pdx-robotics/ElectricSpeedController/Images/20180814_091748.jpg

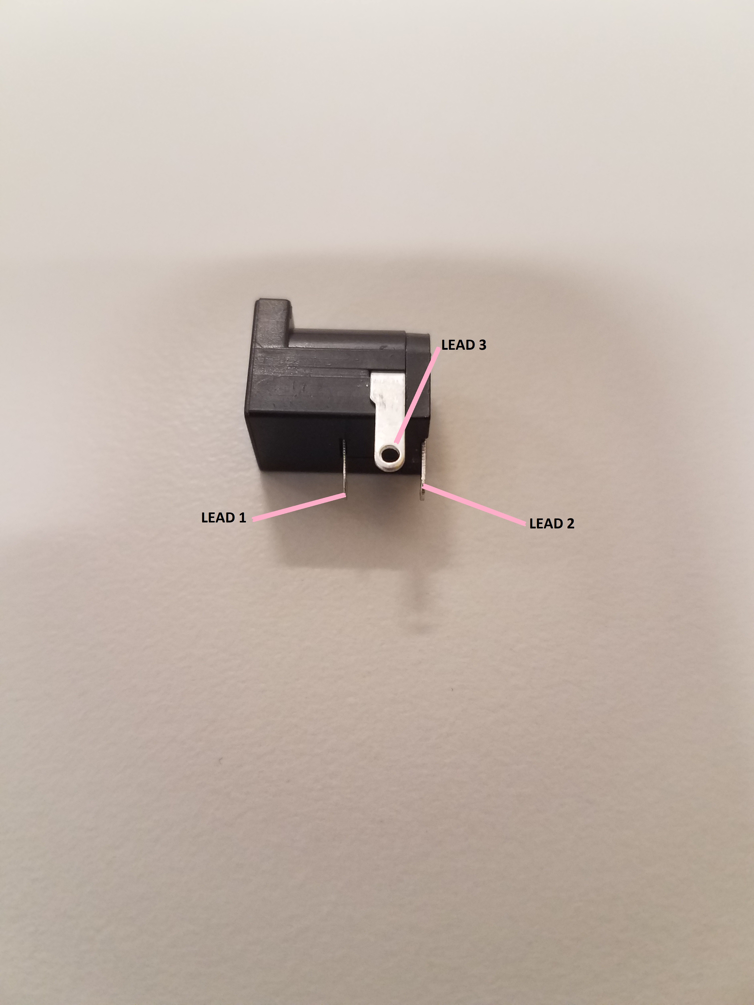
Images/20180814_091748.jpg
