pdx-robotics/ElectricSpeedController/Images/20180814_091755.jpg

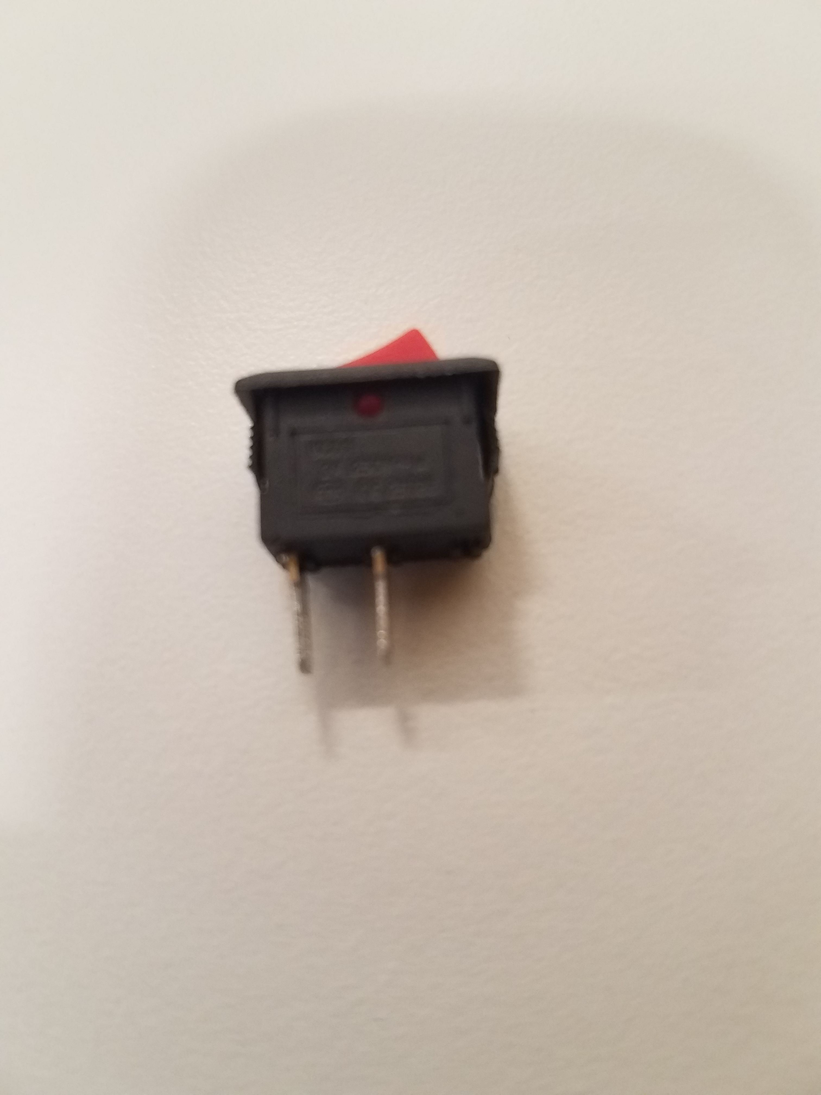
Images/20180814_091755.jpg
