pdx-robotics/ElectricSpeedController/Images/61D4g5iEZIL._SL1100_.jpg

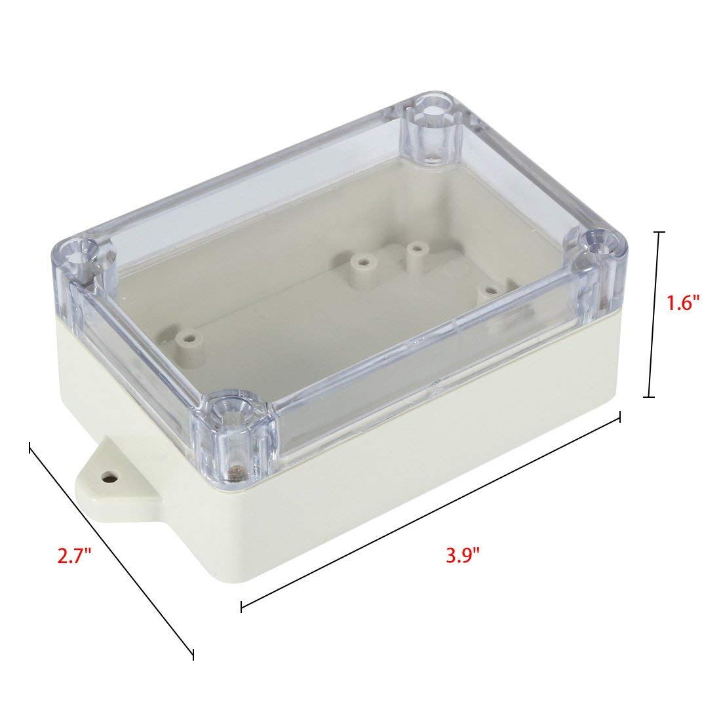
Images/61D4g5iEZIL._SL1100_.jpg
