pdx-robotics/ElectricSpeedController/Images/61FMiCF3CWL._SL1200_.jpg

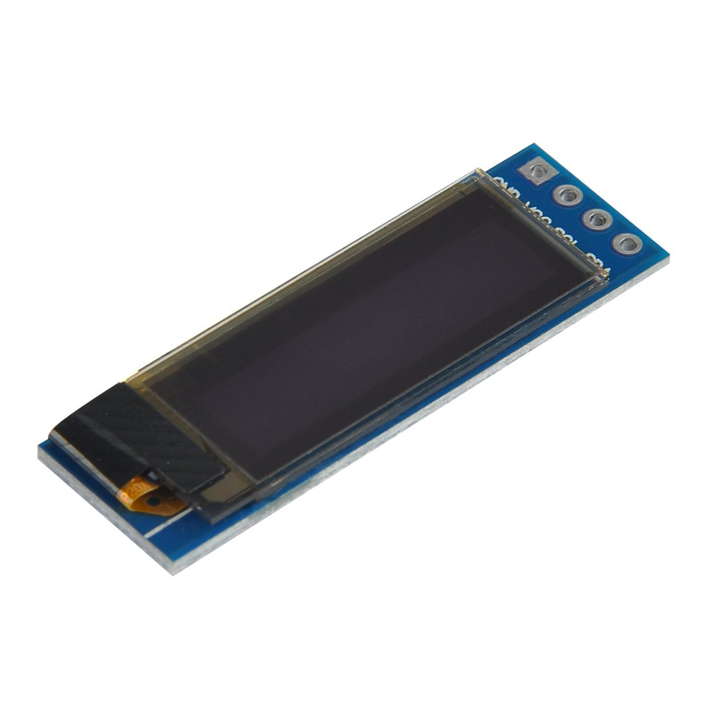
Images/61FMiCF3CWL._SL1200_.jpg
