pdx-robotics/ElectricSpeedController/Images/61v4XPOW-WL._SL1100_.jpg

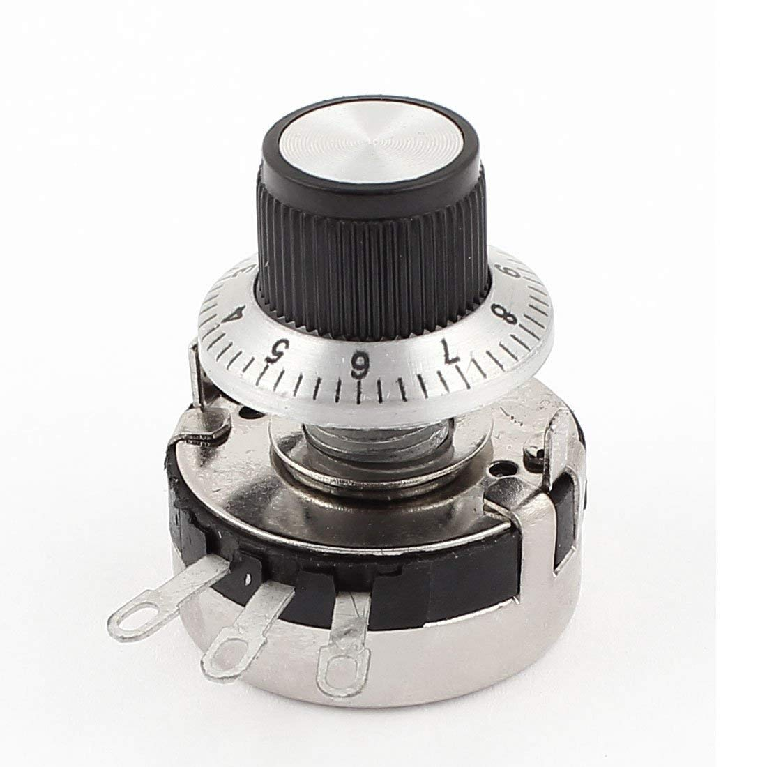
Images/61v4XPOW-WL._SL1100_.jpg
