pdx-robotics/ElectricSpeedController/Images/81rjkZYOmPL._SL1500_.jpg

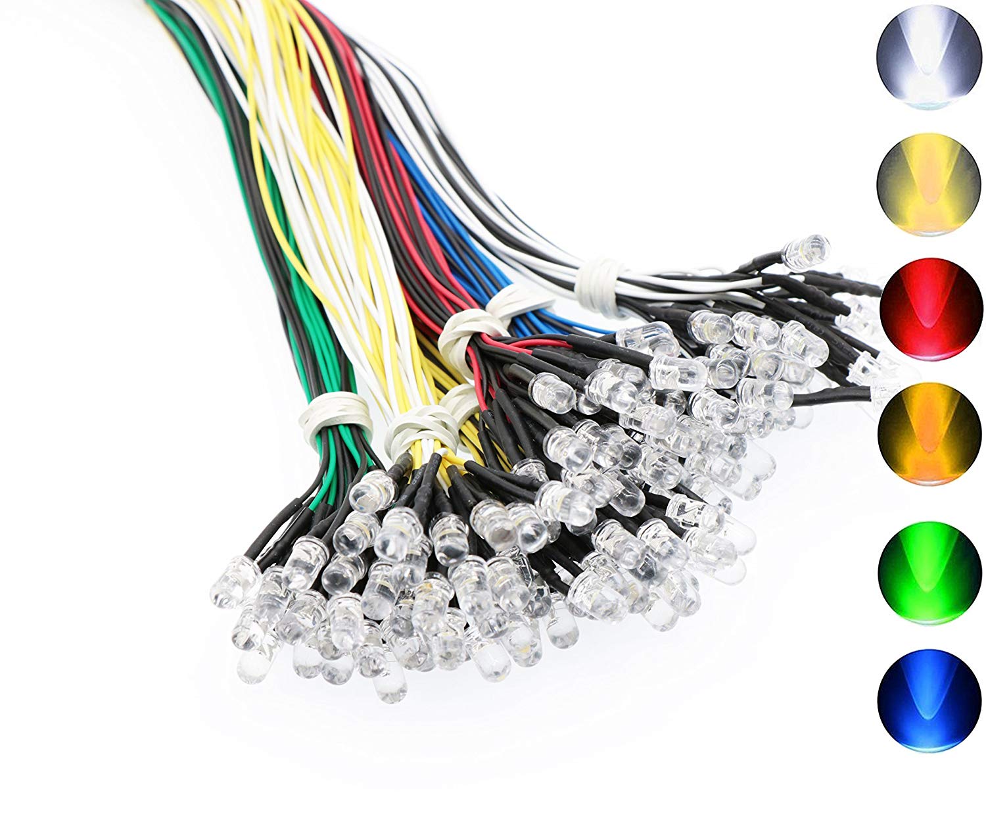
Images/81rjkZYOmPL._SL1500_.jpg
