pdx-robotics/ElectricSpeedController/Images/20180814_091734.jpg

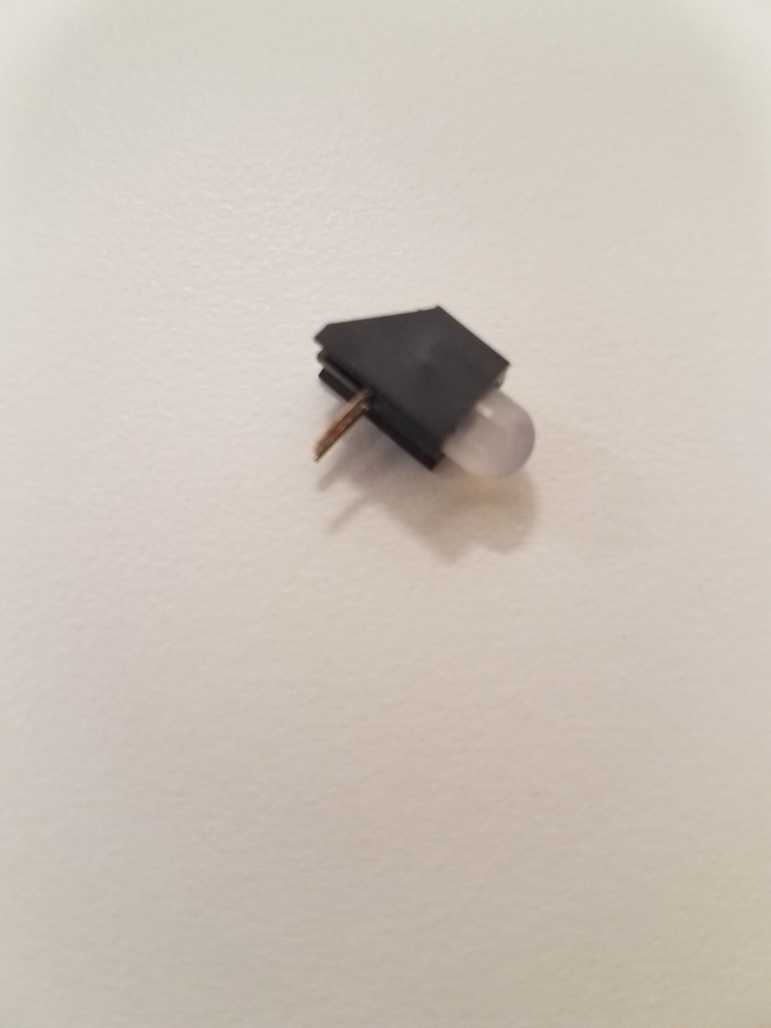
Images/20180814_091734.jpg
