pdx-robotics/ElectricSpeedController/Images/20180925_155454.jpg

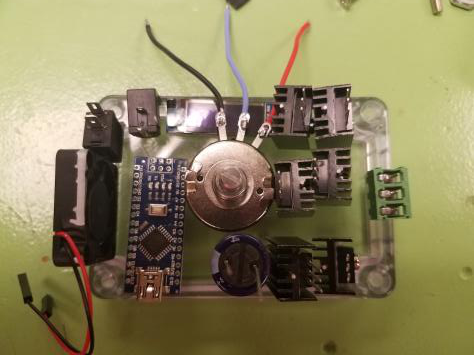
Images/20180925_155454.jpg
