pdx-robotics/ElectricSpeedController/Images/schematic.png

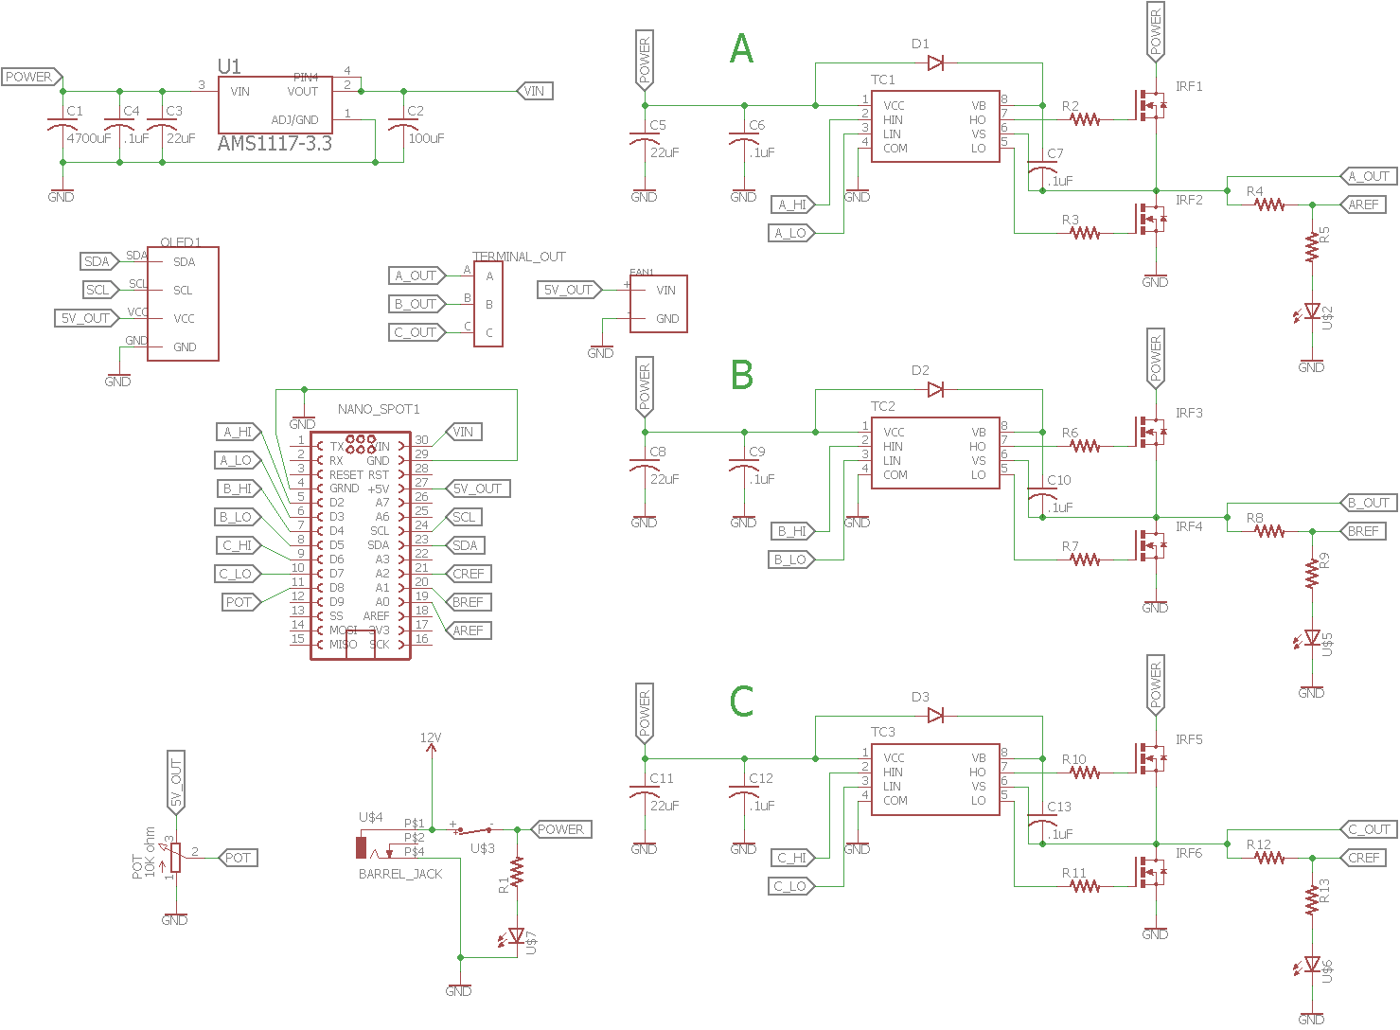
Images/schematic.png
