pdx-robotics/ElectricSpeedController/ESC.pdf

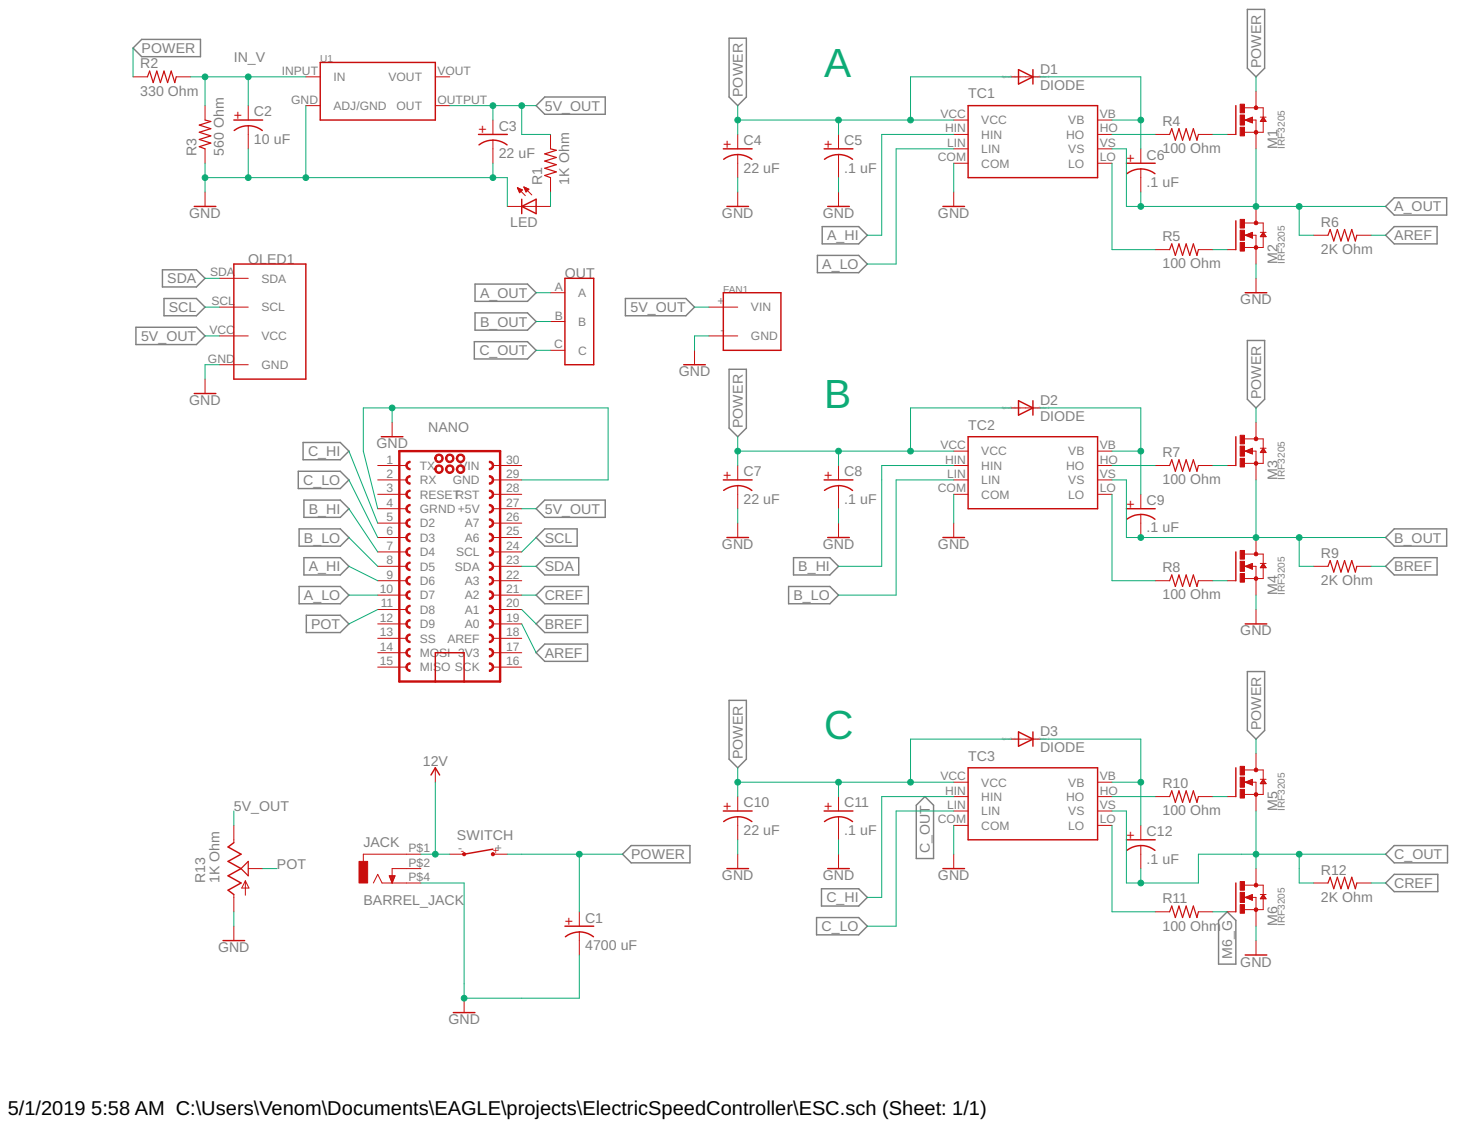
[picture p14: page 1]

5/1/2019 5:58 AM C:\Users\Venom\Documents\EAGLE\projects\ElectricSpeedController\ESC.sch (Sheet: 1/1)
