pdx-robotics/ElectricSpeedController/ESC.brd

## EAGLE design ESC.brd (2019-05-01)

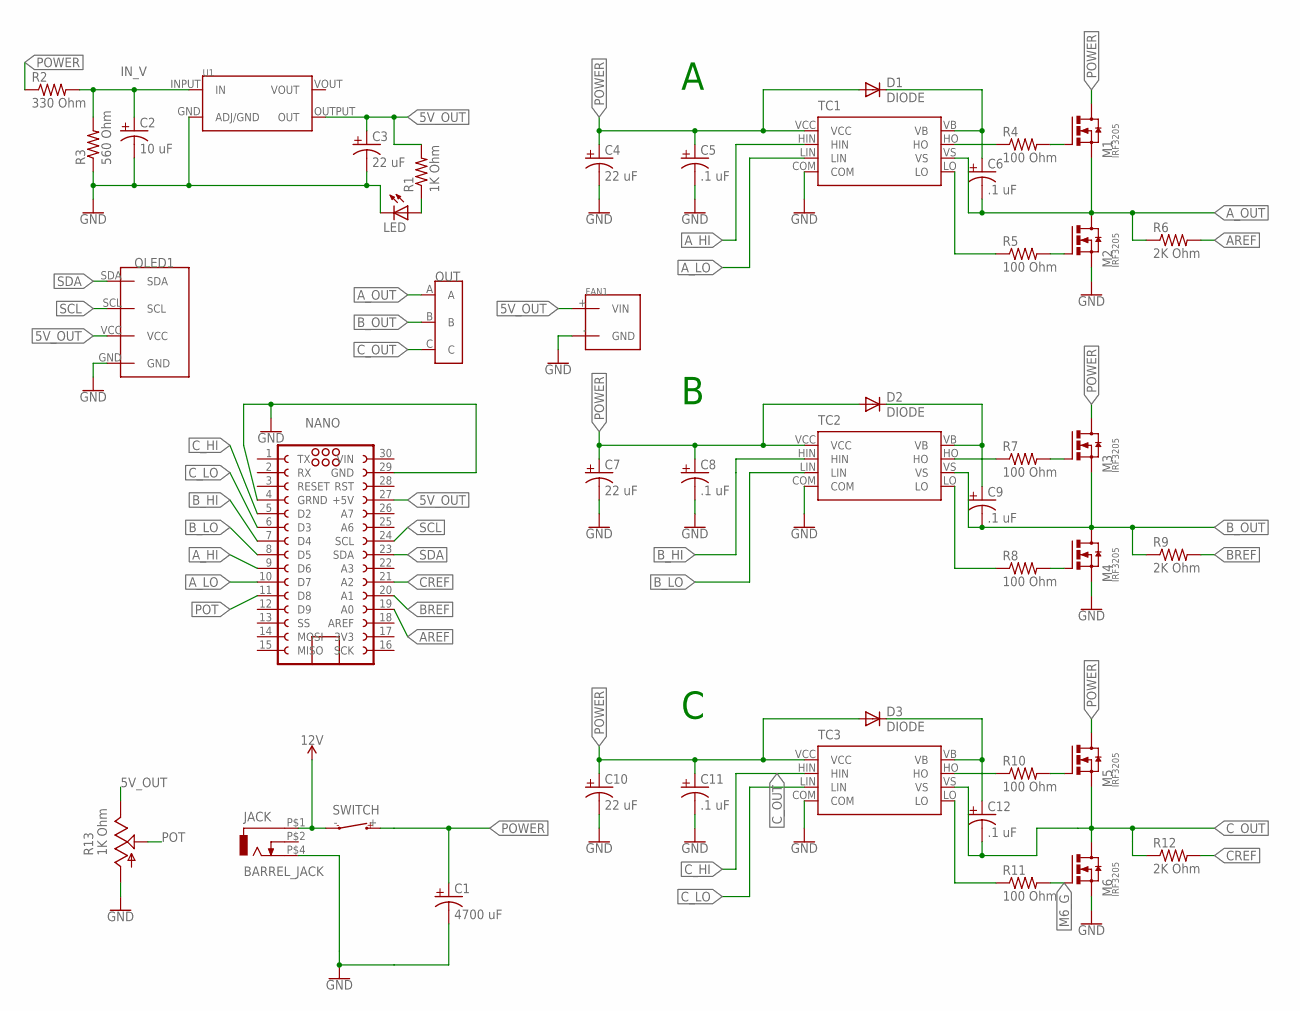
[picture p15: schematic ESC.sch]

Parts:
C1: 4700 uF; CAP_LARGE
C2: 10 uF; 0805
C3, C4, C7, C10: 22 uF; 0805
C5, C6, C8, C9, C11, C12: .1 uF; 0805
D1, D2, D3: DIODE
FAN1: 2P_POWER
JACK: BARREL_JACK
LED: LED; LED_PADS
M1, M2, M3, M4, M5, M6: IRF3205
NANO: ARDUINO_NANO_CONNECTOR; ARDUINO_NANO_HEADER
OLED1: I2C_OLED_4PIN_HEADER; OLED_CONNECTION
OUT: TERMINAL3; 3PIN_TERMINAL
R1: 1K Ohm; 0805
R2: 330 Ohm; RESISTOR
R3: 560 Ohm; RESISTOR
R4, R5, R7, R8, R10, R11: 100 Ohm; 0805
R6, R9, R12: 2K Ohm; 0805
R13: 1K Ohm; POT
SWITCH: BOAT_SWITCH; 2P_POWER
TC1, TC2, TC3: TSC428CPA; PDIP-8_N
U1: AZ1117CH

Connections:
3V3: NANO.17 (3V3)
5V_OUT: C3.1 (ANODE), FAN1.+ (VIN), NANO.27 (+5V), OLED1.VCC, R1.2, R13.+, U1.OUTPUT (OUT)
12V: JACK.P$1 (1), SWITCH.-
AREF: NANO.19 (A0), R6.2
A_HI: NANO.9 (D6), TC1.HIN
A_LO: NANO.10 (D7), TC1.LIN
A_OUT: C6.2 (CATHODE), M1.SOURCE (S), M2.DRAIN (D), OUT.A, R6.1, TC1.VS
BREF: NANO.20 (A1), R9.2
B_HI: NANO.7 (D4), TC2.HIN
B_LO: NANO.8 (D5), TC2.LIN
B_OUT: C9.2 (CATHODE), M3.SOURCE (S), M4.DRAIN (D), OUT.B, R9.1, TC2.VS
CREF: NANO.21 (A2), R12.2
C_HI: NANO.5 (D2), TC3.HIN
C_LO: NANO.6 (D3), TC3.LIN
C_OUT: C12.2 (CATHODE), M5.SOURCE (S), M6.DRAIN (D), OUT.C, R12.1, TC3.VS
GND: C1.CATHODE, C2.2 (CATHODE), C3.2 (CATHODE), C4.2 (CATHODE), C5.2 (CATHODE), C7.2 (CATHODE), C8.2 (CATHODE), C10.2 (CATHODE), C11.2 (CATHODE), FAN1.- (GND), JACK.P$4 (3), LED.C, M2.SOURCE (S), M4.SOURCE (S), M6.SOURCE (S), NANO.4 (GRND), NANO.29 (GND), OLED1.GND, R3.P$1 (1), R13.-, TC1.COM, TC2.COM, TC3.COM, U1.GND (ADJ/GND)
IN_V: C2.1 (ANODE), R2.P$2 (2), R3.P$2 (2), U1.INPUT (IN)
M6_G: M6.GATE (G), R11.2
unnamed: M2.GATE (G), R5.2
unnamed: LED.A, R1.1
unnamed: R4.1, TC1.HO
unnamed: M1.GATE (G), R4.2
unnamed: R5.1, TC1.LO
unnamed: C6.1 (ANODE), D1.C, TC1.VB
unnamed: M3.GATE (G), R7.2
unnamed: M4.GATE (G), R8.2
unnamed: R7.1, TC2.HO
unnamed: R8.1, TC2.LO
unnamed: C9.1 (ANODE), D2.C, TC2.VB
unnamed: M5.GATE (G), R10.2
unnamed: R10.1, TC3.HO
unnamed: R11.1, TC3.LO
unnamed: C12.1 (ANODE), D3.C, TC3.VB
POT: NANO.11 (D8), R13.VAR
POWER: C1.ANODE, C4.1 (ANODE), C5.1 (ANODE), C7.1 (ANODE), C8.1 (ANODE), C10.1 (ANODE), C11.1 (ANODE), D1.A, D2.A, D3.A, M1.DRAIN (D), M3.DRAIN (D), M5.DRAIN (D), R2.P$1 (1), SWITCH.+, TC1.VCC, TC2.VCC, TC3.VCC
SCL: NANO.24 (SCL), OLED1.SCL
SDA: NANO.23 (SDA), OLED1.SDA

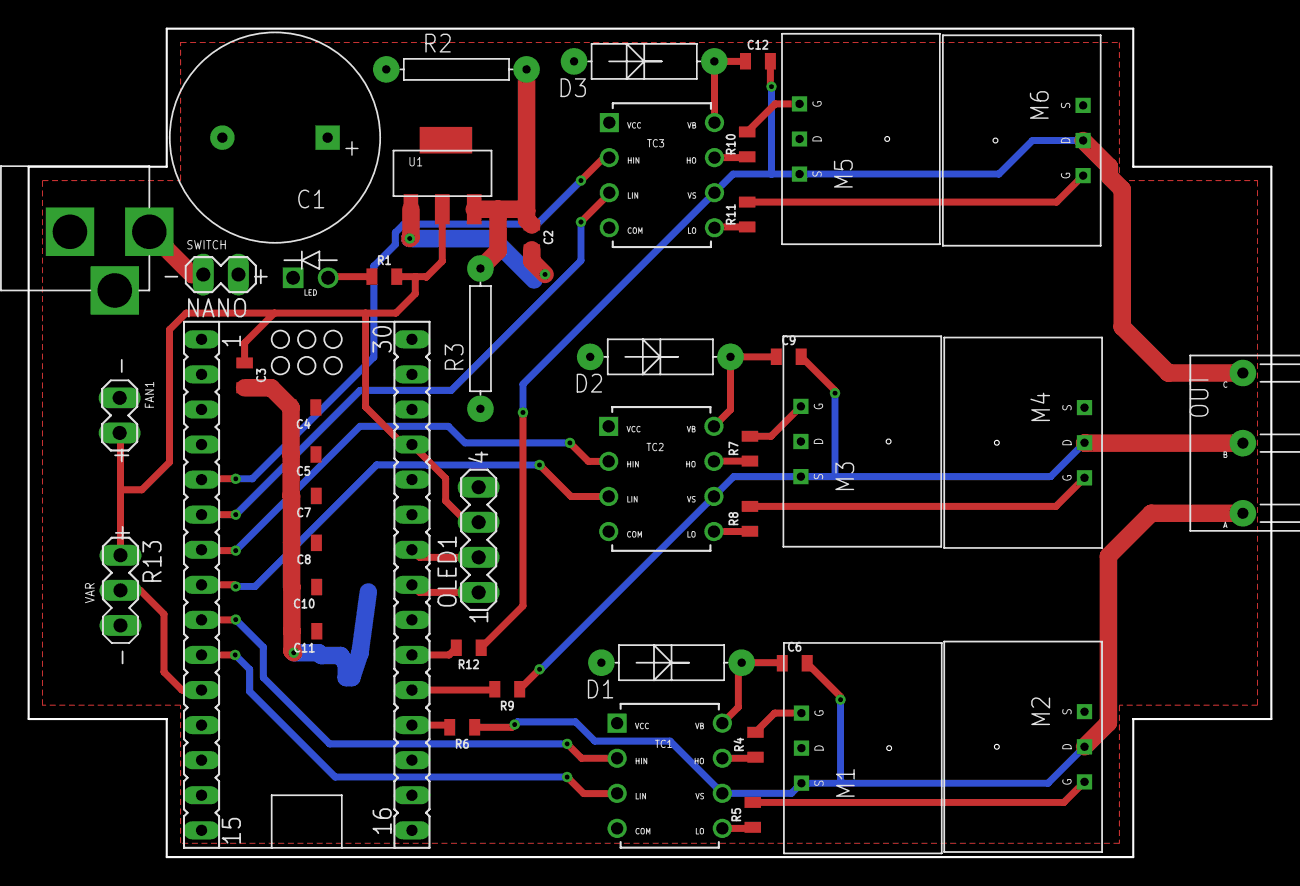
[picture p16: board ESC.brd from above]

Board: 2 copper layers, 90.0 x 60.0 mm, 45 parts (0 on the bottom side), 36 nets.
