pdx-robotics/ElectricSpeedController/(threads)

Thread 1 (2018-08-08):

Test Components

PrestonCazier, 2018-08-08:
- [ ] Test OLED Screen, using default libraries for functionality and general "it works"edness
- [ ] Test 4700uF capacitor to see if they are within tolerance
- [ ] Test 100uF capacitor to see if they are within tolerance
- [ ] Test smd capacitors to see if they are within tolerance
- [ ] Test resistors to see if they are within tolerance
- [ ] Test potentiometer to verify leads

PrestonCazier, 2018-08-14:
Amazon item page: https://www.amazon.com/gp/product/B0761LV1SD/ref=oh_aui_detailpage_o01_s01?ie=UTF8&psc=1

says that the OLED screen should work with Adafruit_GFX and Adafruit_SSD1306
to do the testing we will have to find the correct library and learn to use it

the goal of the OLED screen in the project is to have a display that will show the speed that the brushless motor is set to by the potentiometer

useful links:
https://learn.adafruit.com/monochrome-oled-breakouts/arduino-library-and-examples
http://www.miniarduino.com/makerfocus-2pcs-i2c-oled-display-module-0-91-inch-i2c-ssd1306-oled-display-module-blue-i2c-oled-screen-driver-dc-3-3v5v-for-arduino/

PrestonCazier, 2018-08-14:
For the SMD components, a test case has been made but DO NOT TEST/OPEN/DO ANYTHING with these components yet

PrestonCazier, 2018-08-14:
The final test that can be done right now involves the Pot, we need to verify the leads, the outside two should be the through line and the middle one should be how we read the change in voltage/resistance.  this test also involves verifying that this is a 10k pot.  what is its maximum resistance

fill in test results [here](https://github.com/pdx-robotics/ElectricSpeedController/wiki/Component-Test:-Potentiometer)

PrestonCazier, 2018-08-14:
For the power jack we need more information on how to get it to work in a circuit to provide power.  what are the 3 leads for?
[Amazon item page](https://www.amazon.com/gp/product/B00W944ACE/ref=oh_aui_detailpage_o01_s02?ie=UTF8&psc=1)
Fill in test results [here](https://github.com/pdx-robotics/ElectricSpeedController/wiki/Component-Test:-Power-Jack)

PrestonCazier, 2018-08-14:
also please upload all datasheets and the correct libraries for the OLED to this repo

Chana030102, 2018-08-14:
100 and 100k ohm resistor bags measured and marked by @ianeyk

Chana030102, 2018-08-14:
Remeasured and multi-meter says 102K.

PrestonCazier, 2018-08-14:
thats good to know, also i want to congrads you two on being able to read my comments especially the one that said not to do the SMD

PrestonCazier, 2018-08-14:
also im thinking we maybe should just do through hole components

ianeyk, 2018-08-14:
For the power jacks: Lead 2 is always connected to the power prong (in the middle of the hole). Lead 1 is always connected to the ground tab (bottom of the hole/outside of power plug). When nothing is plugged in, leads 1 and 3 are connected; when the plug is in, the connection is broken.

ianeyk, 2018-08-14:
For the LED: when the leads are facing you and the LED head is facing up, the lead on the left is positive, and the one on the right is negative.

Thread 10 (2018-08-08):

make schematic for control components for motor pole B

PrestonCazier, 2018-08-08:

PrestonCazier, 2018-08-09:
Missing connection to motor terminal

Thread 11 (2018-08-08):

make schematic for control components for motor pole C

PrestonCazier, 2018-08-08:

PrestonCazier, 2018-08-09:
Missing connection to motor terminal

Thread 16 (2018-08-08):

Create Layout Components

PrestonCazier, 2018-08-08:
create/ verify layout component by lead spacing, hole or pad, component height, general size for:
- [ ] smd 0805 resistors
- [ ] smd 0805 capaccitors
- [ ] smd 0604? capacitors
- [ ] 100uF cap
- [ ] 4700uF cap
- [ ] ardiuno nano
- [ ] jumper pins
- [ ] 3 hole power terminal for motor
- [ ] 12V right angle plug
- [ ] 10K potentiometer
- [ ] uf4007 diodes
- [ ] ir2301pbf-nd IC
- [ ] az1117ch voltage regulator
- [ ] irf3205 mosfet
- [ ] little fan
- [ ] OLED

PrestonCazier, 2018-08-14:
OLED, toggle switch, pot and leds are just going to be standard spaced pads that we will solder wires to

PrestonCazier, 2018-08-14:
the little fan will have a layout component that is two standard spaced holes to solder in male header pins

PrestonCazier, 2018-08-14:
the diodes are going to have a total spacing width of 5 header pins and will be 2 holes (one for each lead)  essentially it will look like this O---O, where the dashes are a header pin holes width but are not actually there

PrestonCazier, 2018-08-14:
for the mosfet it will be 3 standard holes in a line, like this OOO

PrestonCazier, 2018-08-14:
the layout component for the nano will be just places to solder in 2 rows of 1x15 female header pins, the layout component in the library is 90% done just need to correct the spacing between the two ranks

PrestonCazier, 2018-08-14:
i believe the voltage regulator and the IC are both correct

PrestonCazier, 2018-08-14:
the three terminal has a spacing of 5 pins laid out like this O-O-O

PrestonCazier, 2018-08-14:
100uF cap has a spacing of 2 pins, needs holes

PrestonCazier, 2018-08-14:
4700uF cap is unmeasured

Thread 17 (2018-08-08):

Create custom component library

PrestonCazier, 2018-08-08:
create/ verify layout component and schematic for:
- [x] smd 0805 resistors
- [ ] smd 0805 capaccitors
- [ ] smd 0604? capacitors
- [ ] 100uF cap
- [ ] 4700uF cap
- [ ] ardiuno nano
- [ ] jumper pins
- [ ] 3 hole power terminal for motor
- [ ] 12V right angle plug
- [ ] 10K potentiometer
- [ ] uf4007 diodes
- [ ] ir2301pbf-nd IC
- [ ] az1117ch voltage regulator
- [ ] irf3205 mosfet
- [ ] little fan
- [ ] OLED

Thread 18 (2018-08-08):

Create component schematic

PrestonCazier, 2018-08-08:
create/ verify schematic for:
- [x] smd 0805 resistors
- [ ] smd 0805 capaccitors
- [ ] smd 0604? capacitors
- [ ] 100uF cap
- [ ] 4700uF cap
- [ ] ardiuno nano
- [ ] jumper pins
- [ ] 3 hole power terminal for motor
- [ ] 12V right angle plug
- [ ] 10K potentiometer
- [ ] uf4007 diodes
- [ ] ir2301pbf-nd IC
- [ ] az1117ch voltage regulator
- [ ] irf3205 mosfet
- [ ] little fan
- [ ] OLED

PrestonCazier, 2018-08-14:
little fan can be as simple a a box with 2 leads, one for power and one for ground.  be sure to note on the schematic what the required voltage is

PrestonCazier, 2018-08-14:
the 3 terminal power terminal can be a box with 3 leads labeled A, B and C

Thread 2 (2018-08-08):

PROJECT: Coding

PrestonCazier, 2018-08-08:
Issue to track and correlate the progress of the Code project and Summer 2018 Quarter 3 milestone

Thread 3 (2018-08-08):

PROJECT: Schematic

PrestonCazier, 2018-08-08:
Issue to track and correlate the progress of the Schematic project and Summer 2018 Quarter 3 milestone

Thread 4 (2018-08-08):

PROJECT: Component Layout

PrestonCazier, 2018-08-08:
Issue to track and correlate the progress of the Component Layout project and Summer 2018 Quarter 3 milestone

Thread 9 (2018-08-08):

make schematic for control components for motor pole A

PrestonCazier, 2018-08-08:

PrestonCazier, 2018-08-09:
Missing connection to motor terminal
