pdx-robotics/ElectricSpeedController/(commit log)

2018-08-14 REQUIRES SPARKFUN EAGLE LIBRARY FROM README TUTORIALS
    [ESC.sch]
2018-08-25 reorganized file structure
    [ESC.sch]
2018-09-25 lastest edits
    [ESC.sch]
2018-09-28 Fixed resistor spacing
2018-10-02 daily updates 10022018
    [ESC.sch]
2018-10-04 daily changes for 10042018
    [ESC.sch]
2018-10-05 daily updates 10052018
    [ESC.sch]
2018-10-06 late changes 10052018
    [ESC.sch]
2018-10-09 added arduino code
2019-04-23 finalized schematic
    [ESC.sch]
2019-04-27 parts library and updated schematic
    [ESC.sch]
2019-05-01 Board Layout v1 final
    [ESC.brd, ESC.sch]
